Race666/masterclock/README.md

# Mutteruhrsteuerung

Firmware und Schaltungen zum Steuern von sog. Nebenuhren (z.B. Bahnhofsuhren)

Dokumentation und Details auf [albert-hetzles.de](http://albert-hetzles.de/mutteruhr/index.shtml)
