Race666/masterclock/Firmware/atmega168/fuses.png

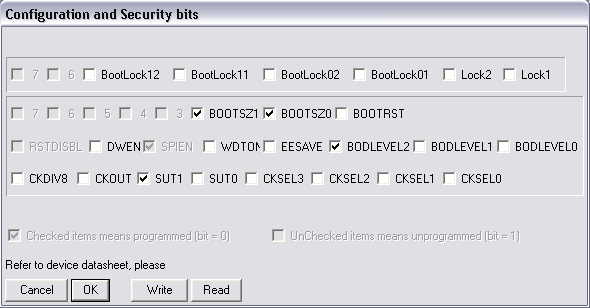
Firmware/atmega168/fuses.png
