Race666/masterclock/Hardware/Mutteruhr V2.0 USB-B - H-Brigde L298 - USB UART LM2576-5/Layout/Bestückung - Mutteruhr-mono-1200dpi.png

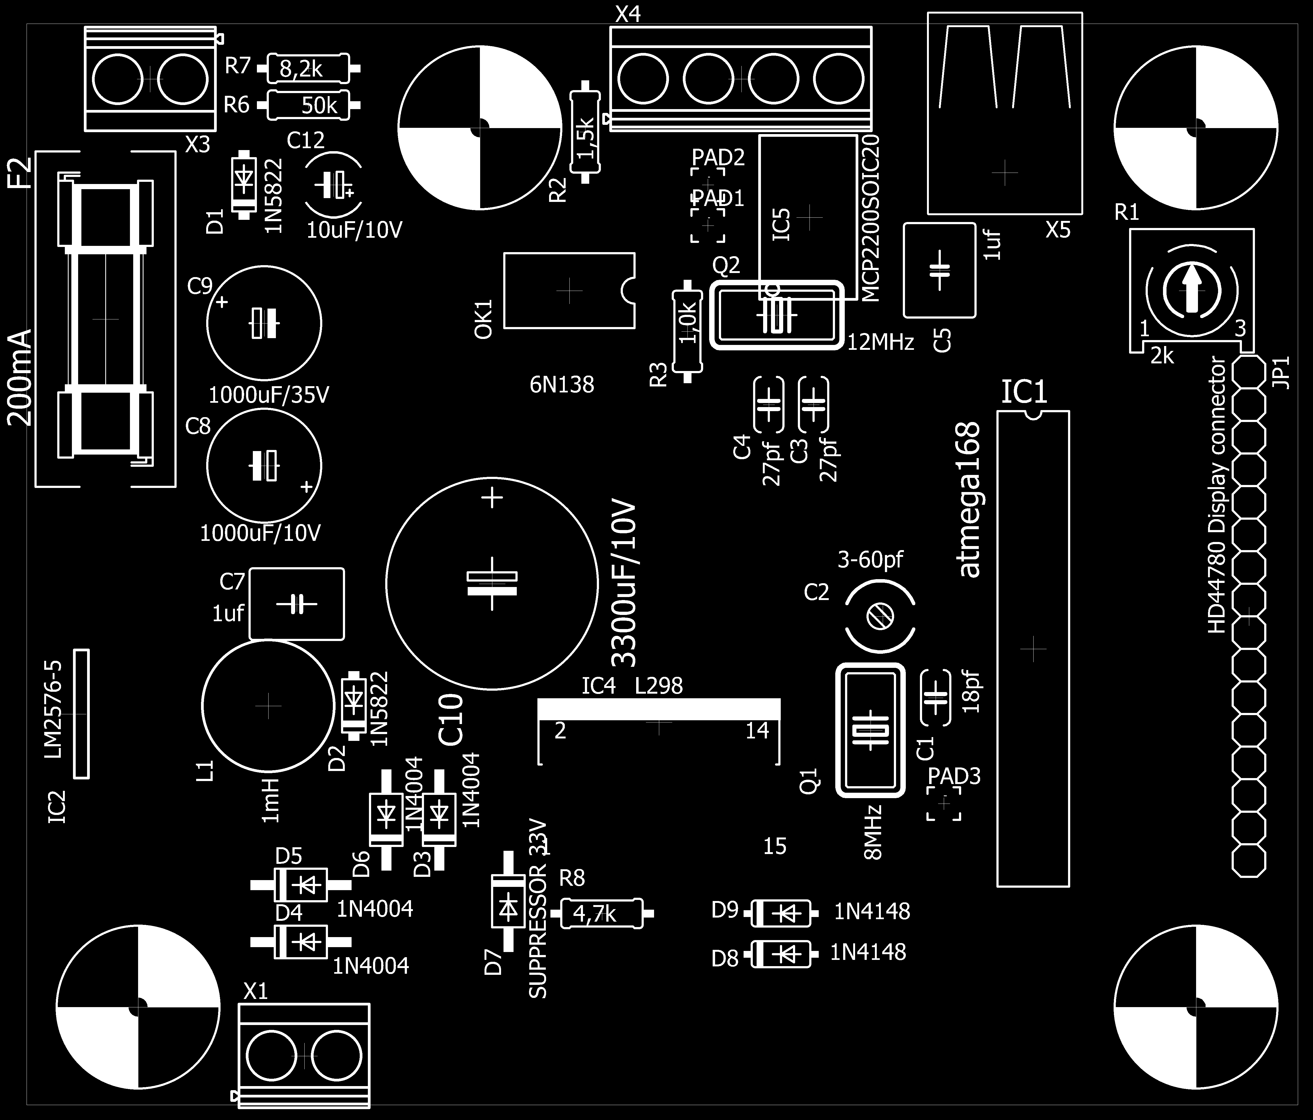
Hardware/Mutteruhr V2.0 USB-B - H-Brigde L298 - USB UART LM2576-5/Layout/Bestückung - Mutteruhr-mono-1200dpi.png
