Race666/masterclock/Hardware/Mutteruhr V2.1 External USB-B - H-Brigde L298 - USB UART LM2576-5/Layout/Bestückung-mutteruhr.png

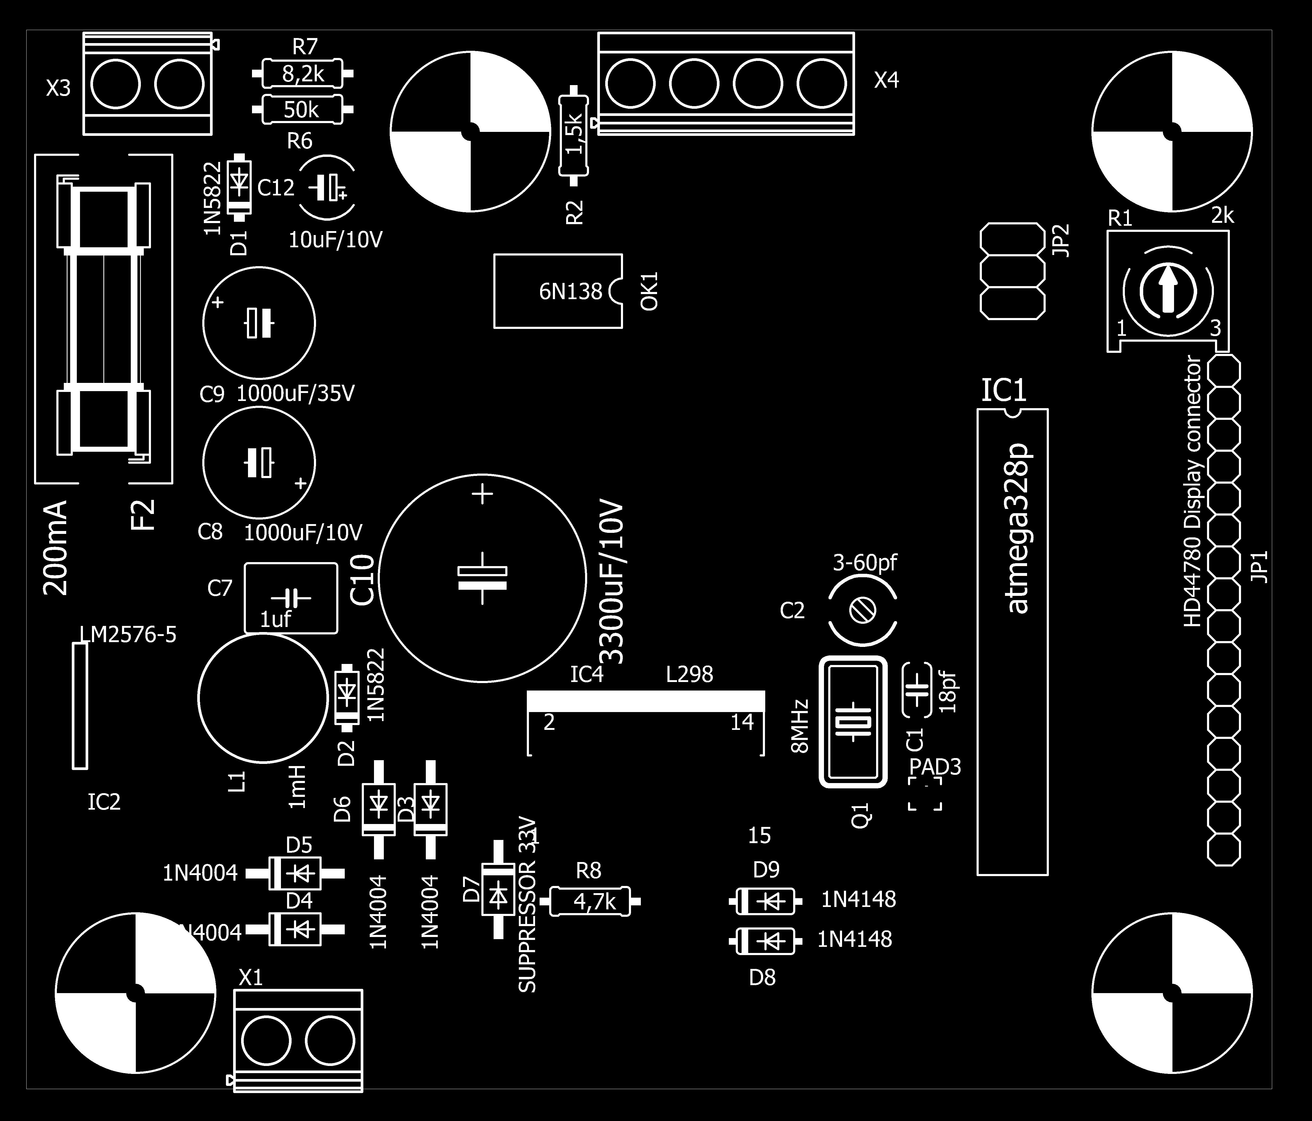
Hardware/Mutteruhr V2.1 External USB-B - H-Brigde L298 - USB UART LM2576-5/Layout/Bestückung-mutteruhr.png
