Race666/masterclock/Hardware/Mutteruhr V3/Mutteruhr/DCF77 Receiver/DCF77 Receiver.kicad_pcb

## KiCad design Hardware/Mutteruhr V3/Mutteruhr/DCF77 Receiver/DCF77 Receiver.kicad_pcb (2023-12-17)

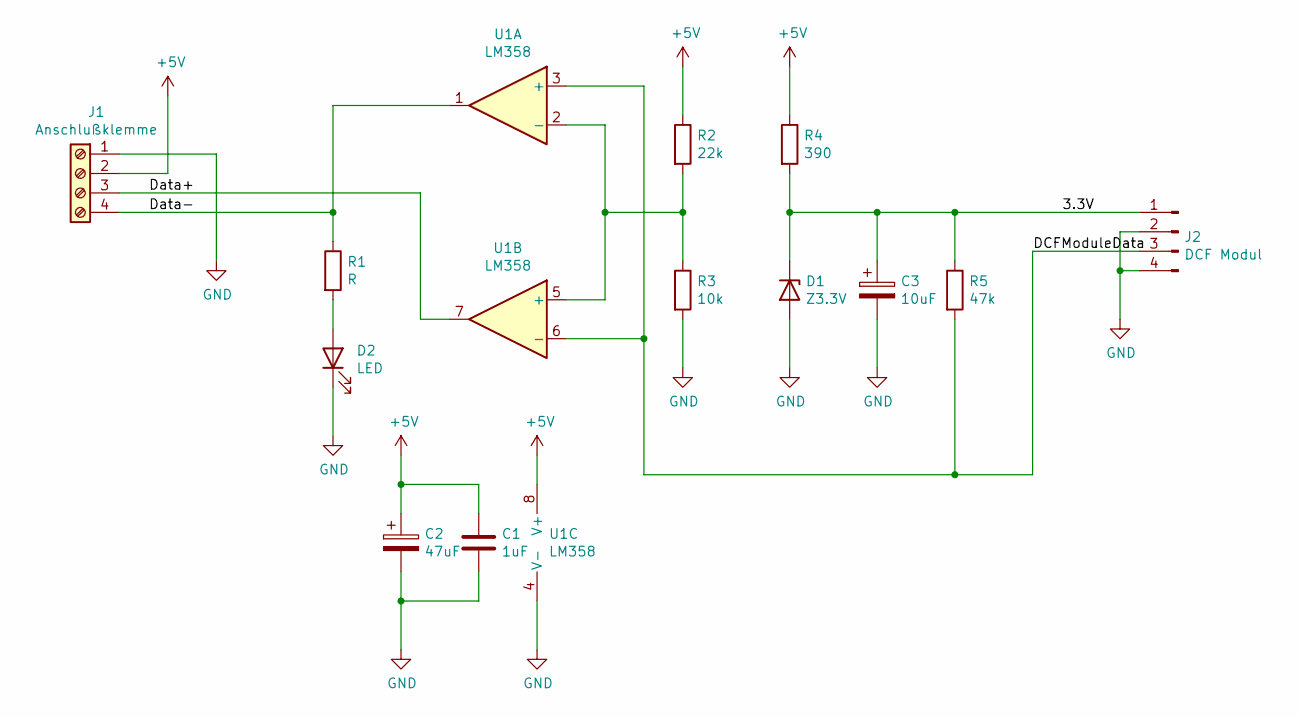
[picture p14: schematic DCF77 Receiver.sch, DCF 77 Empfänger]

Parts:
C1: 1uF; C_Rect_L7.0mm_W3.5mm_P5.00mm
C2: 47uF; CP_Radial_D6.3mm_P2.50mm
C3: 10uF; CP_Radial_D6.3mm_P2.50mm
D1: Z3.3V; D_DO-35_SOD27_P10.16mm_Horizontal
D2: LED; LED_D3.0mm
J1: Anschlußklemme; TerminalBlock_Phoenix_MKDS-3-4-5.08_1x04_P5.08mm_Horizontal
J2: DCF Modul; PinHeader_1x04_P2.54mm_Vertical
R1: R; R_Axial_DIN0207_L6.3mm_D2.5mm_P10.16mm_Horizontal
R2: 22k; R_Axial_DIN0207_L6.3mm_D2.5mm_P10.16mm_Horizontal
R3: 10k; R_Axial_DIN0207_L6.3mm_D2.5mm_P10.16mm_Horizontal
R4: 390; R_Axial_DIN0207_L6.3mm_D2.5mm_P10.16mm_Horizontal
R5: 47k; R_Axial_DIN0207_L6.3mm_D2.5mm_P10.16mm_Horizontal
U1: LM358; DIP-8_W7.62mm_LongPads

Connections:
+5V: C1.1, C2.1, J1.2, R2.1, R4.1, U1.8 (V+)
/3.3V: C3.1, D1.1 (K), J2.1, R4.2, R5.1
/DCFModuleData: J2.3, R5.2, U1.3 (+), U1.6 (-)
/Data+: J1.3, U1.7
/Data-: J1.4, R1.1, U1.1
GND: C1.2, C2.2, C3.2, D1.2 (A), D2.1 (K), J1.1, J2.2, J2.4, R3.2, U1.4 (V-)
unnamed: D2.2 (A), R1.2
unnamed: R2.2, R3.1, U1.2 (-), U1.5 (+)

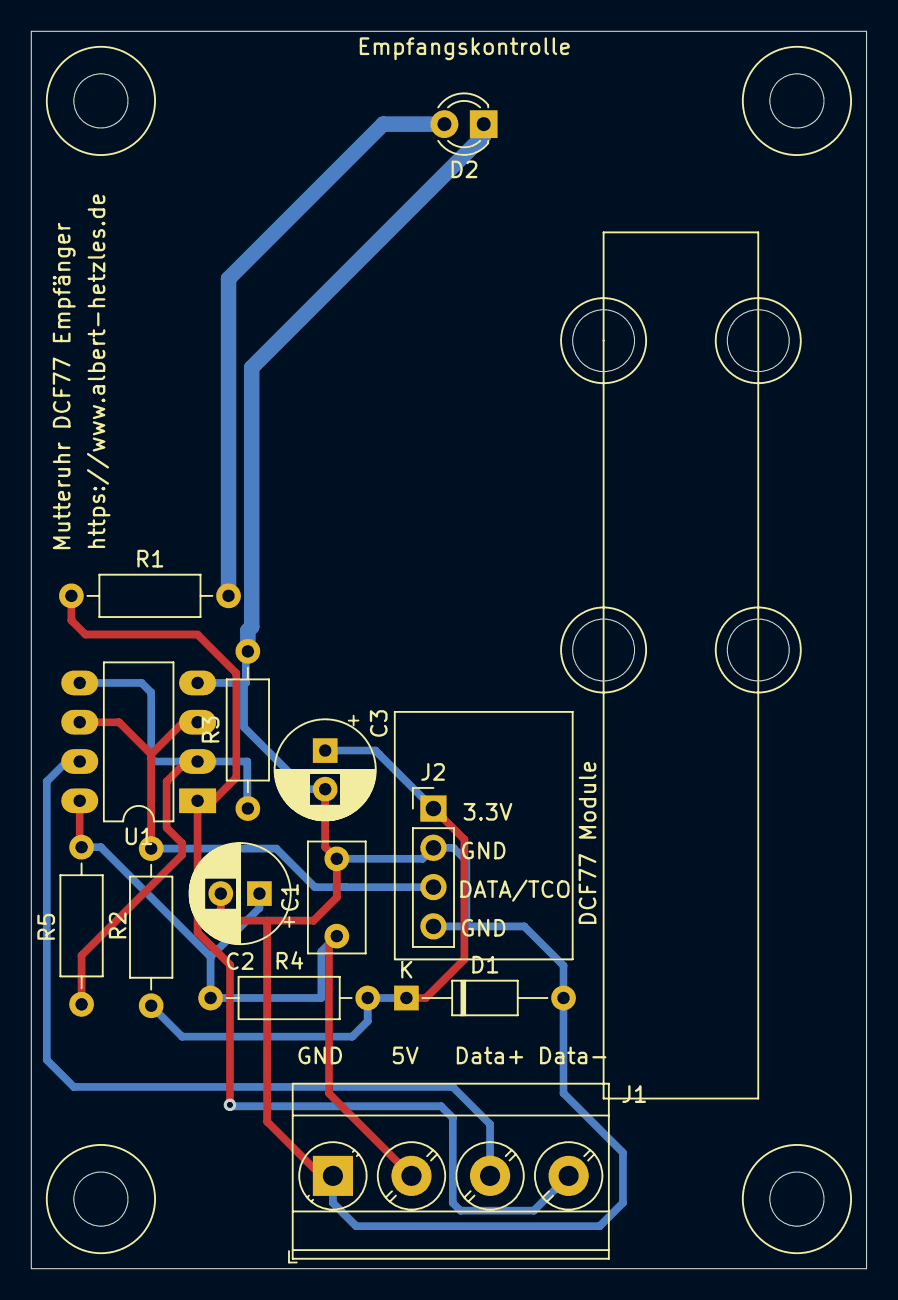
[picture p15: board DCF77 Receiver.kicad_pcb from above]

Board: 2 copper layers, 54.0 x 80.0 mm, 13 parts (0 on the bottom side), 8 nets.
