Race666/masterclock/Hardware/Mutteruhr V3/Mutteruhr/Display/Display Board/Display Board.kicad_pcb

## KiCad design Hardware/Mutteruhr V3/Mutteruhr/Display/Display Board/Display Board.kicad_pcb (2023-12-17)

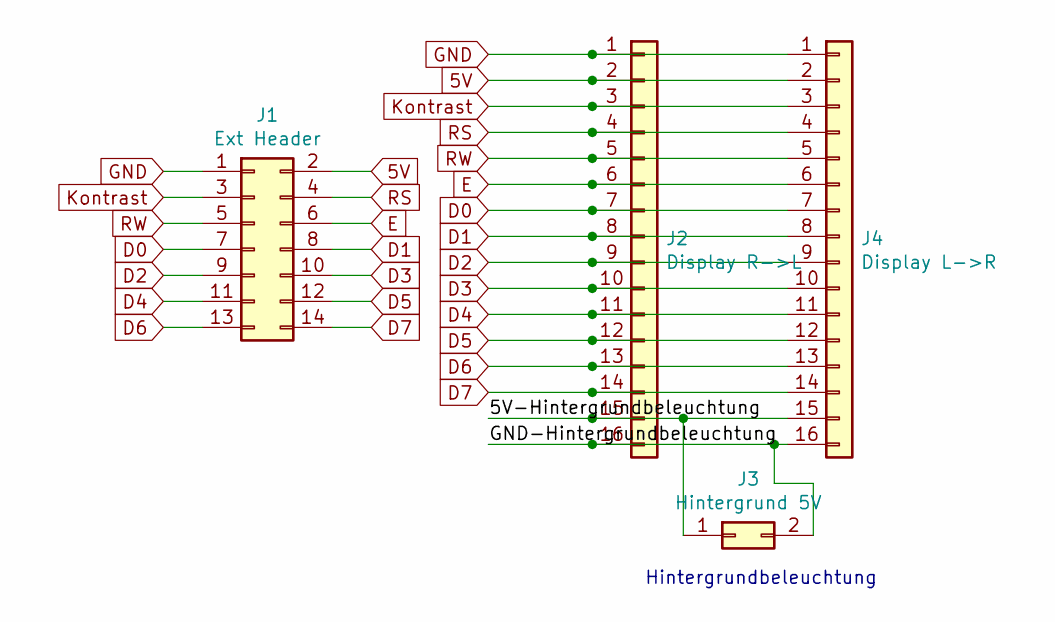
[picture p16: schematic Display Board.sch]

Parts:
J1: Ext Header; PinHeader_2x07_P2.54mm_Vertical
J2: Display R->L; PinHeader_1x16_P2.54mm_Vertical
J3: Hintergrund 5V; PinHeader_1x02_P2.54mm_Vertical
J4: Display L->R; PinHeader_1x16_P2.54mm_Vertical

Connections:
5V: J1.2, J2.2, J4.2
/5V-Hintergrundbeleuchtung: J2.15, J3.1, J4.15
/GND-Hintergrundbeleuchtung: J2.16, J3.2, J4.16
D0: J1.7, J2.7, J4.7
D1: J1.8, J2.8, J4.8
D2: J1.9, J2.9, J4.9
D3: J1.10, J2.10, J4.10
D4: J1.11, J2.11, J4.11
D5: J1.12, J2.12, J4.12
D6: J1.13, J2.13, J4.13
D7: J1.14, J2.14, J4.14
E: J1.6, J2.6, J4.6
GND: J1.1, J2.1, J4.1
Kontrast: J1.3, J2.3, J4.3
RS: J1.4, J2.4, J4.4
RW: J1.5, J2.5, J4.5

Notes on the sheet:
Hintergrundbeleuchtung

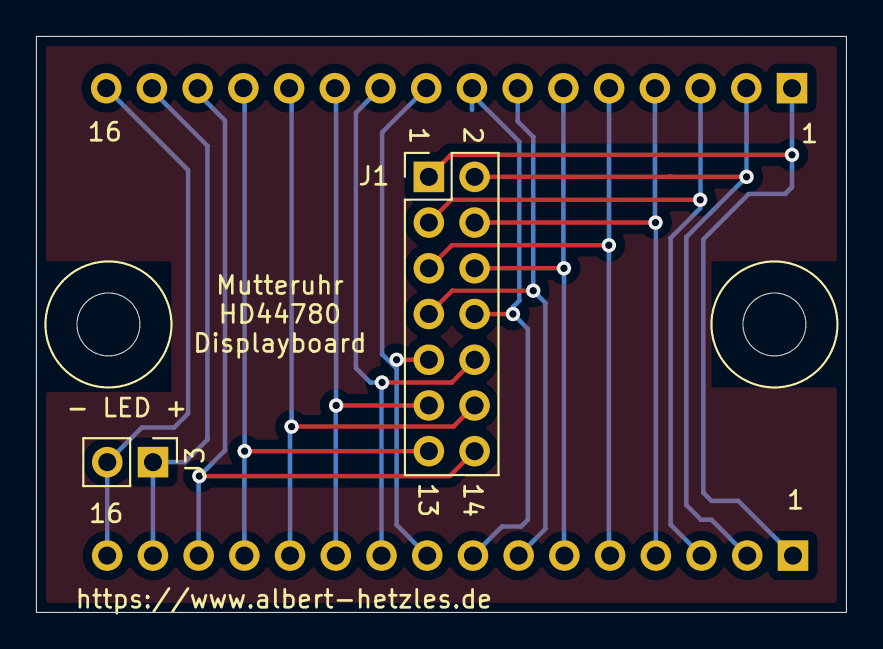
[picture p17: board Display Board.kicad_pcb from above]

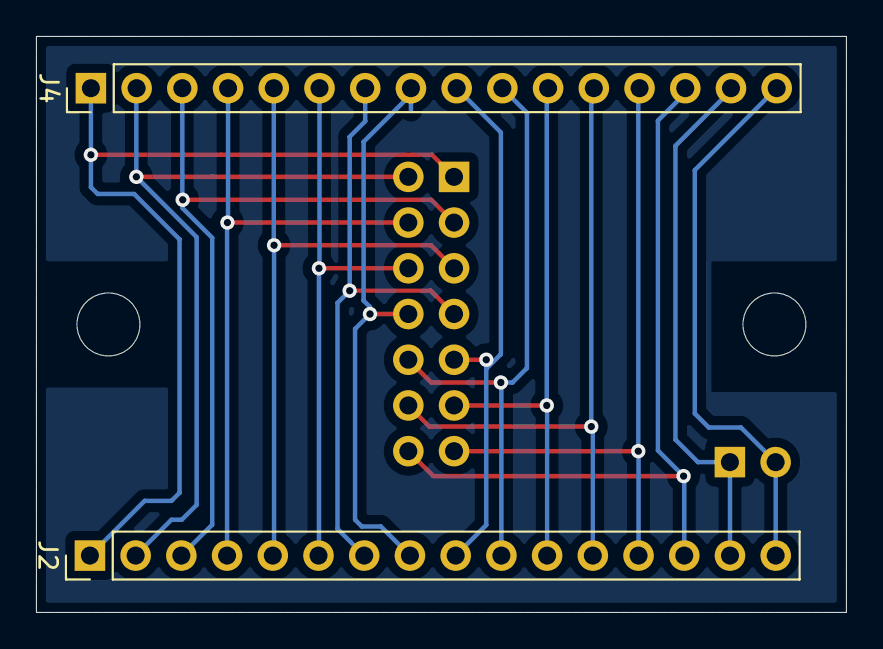
[picture p18: board Display Board.kicad_pcb from below]

Board: 2 copper layers, 45.0 x 32.0 mm, 4 parts (2 on the bottom side), 16 nets.
