Race666/masterclock/Hardware/Mutteruhr V3/Mutteruhr/Mutteruhr/Mutteruhr.kicad_pcb

## KiCad design Hardware/Mutteruhr V3/Mutteruhr/Mutteruhr/Mutteruhr.kicad_pcb (2023-12-17)

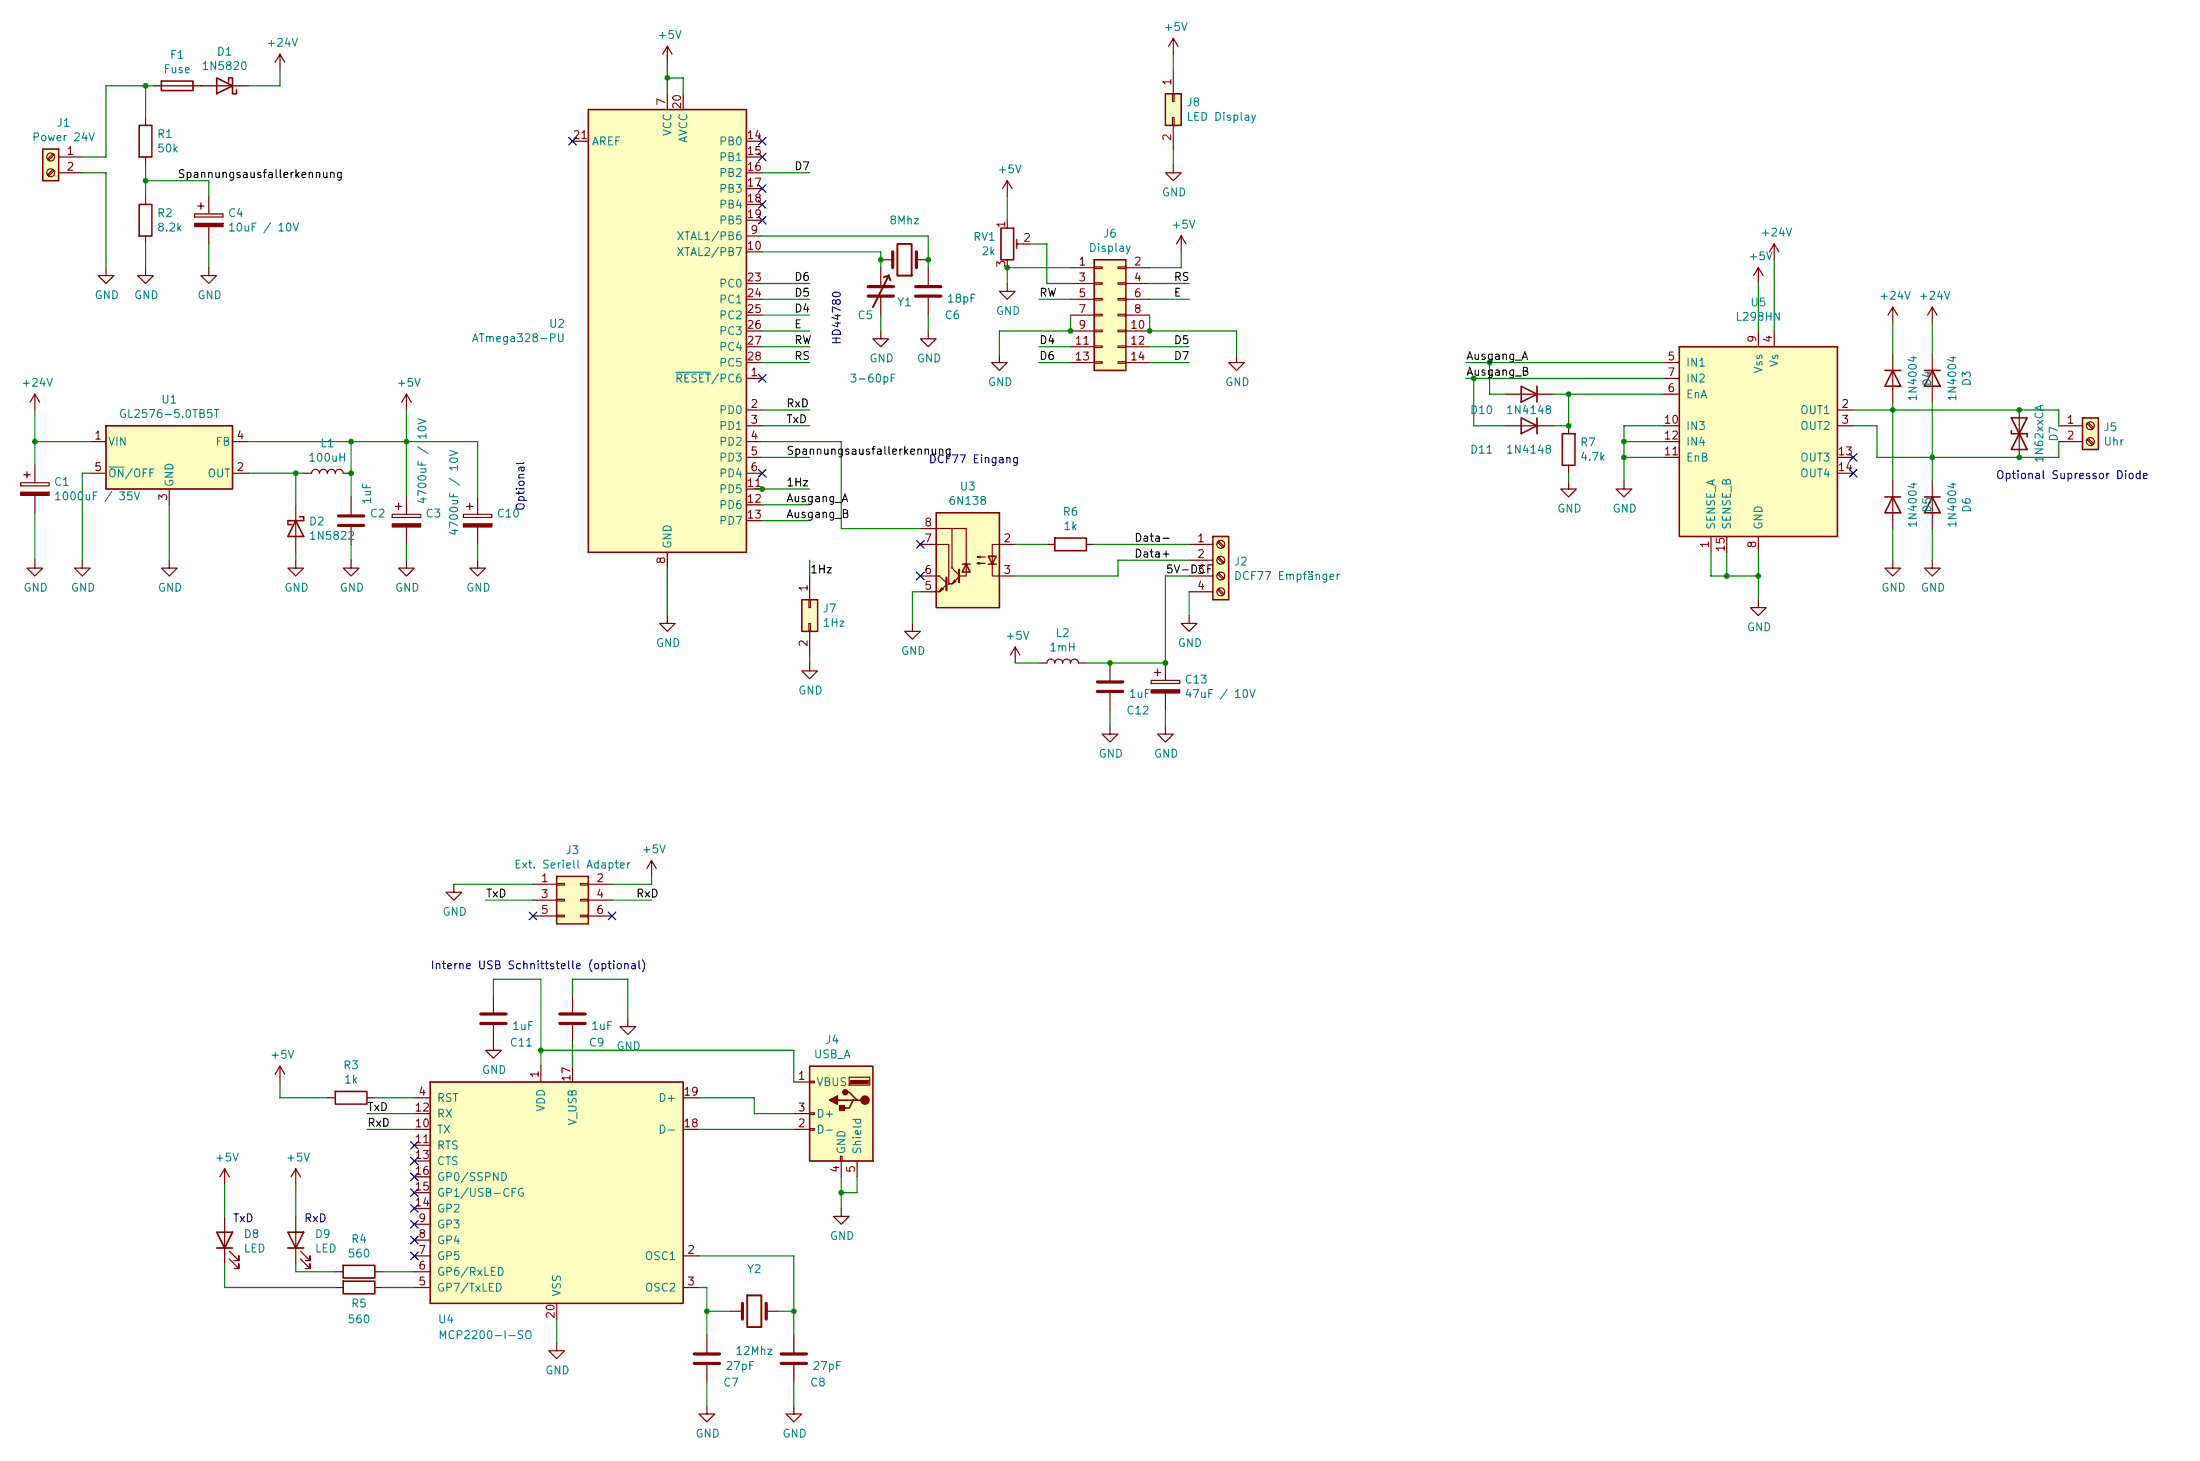
[picture p19: schematic Mutteruhr.kicad_sch, Mutteruhr Mainboard]

Parts:
C1: 1000uF / 35V; CP_Radial_D8.0mm_P5.00mm
C2, C9, C11, C12: 1uF; C_Rect_L7.0mm_W6.0mm_P5.00mm
C3, C10: 4700uF / 10V; CP_Radial_D10.0mm_P7.50mm
C4: 10uF / 10V; CP_Radial_D5.0mm_P2.50mm
C5: 3-60pF; C_Disc_D7.5mm_W5.0mm_P5.00mm
C6: 18pF; C_Disc_D3.0mm_W2.0mm_P2.50mm
C7, C8: 27pF; C_Disc_D3.0mm_W2.0mm_P2.50mm
C13: 47uF / 10V; CP_Radial_Tantal_D4.5mm_P2.50mm
D1: 1N5820; D_DO-41_SOD81_P10.16mm_Horizontal
D2: 1N5822; D_DO-41_SOD81_P10.16mm_Horizontal
D3, D4, D5, D6: 1N4004; D_DO-41_SOD81_P10.16mm_Horizontal
D7: 1N62xxCA; D_DO-41_SOD81_P10.16mm_Horizontal
D8, D9: LED; LED_D3.0mm_FlatTop
D10, D11: 1N4148; D_DO-35_SOD27_P7.62mm_Horizontal
F1: Fuse; Fuse_Bourns_MF-RHT500
J1: Power 24V; TerminalBlock_Phoenix_MKDS-1,5-2-5.08_1x02_P5.08mm_Horizont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
J2: DCF77 Empfänger; TerminalBlock_Phoenix_MKDS-1,5-4-5.08_1x04_P5.08mm_Horizont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
J3: Ext. Seriell Adapter; PinHeader_2x03_P2.54mm_Vertical
J4: USB_A; USB_B_OST_USB-B1HSxx_Horizontal
J5: Uhr; TerminalBlock_Phoenix_MKDS-1,5-2-5.08_1x02_P5.08mm_Horizont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
J6: Display; PinHeader_2x07_P2.54mm_Vertical
J7: 1Hz; PinHeader_1x02_P2.54mm_Vertical
J8: LED Display; PinHeader_1x02_P2.54mm_Vertical
L1: 100uH; L_Radial_D8.7mm_P5.00mm_Fastron_07HCP
L2: 1mH; L_Radial_D8.7mm_P5.00mm_Fastron_07HCP
R1: 50k; R_Axial_DIN0207_L6.3mm_D2.5mm_P10.16mm_Horizontal
R2: 8.2k; R_Axial_DIN0207_L6.3mm_D2.5mm_P10.16mm_Horizontal
R3, R6: 1k; R_Axial_DIN0207_L6.3mm_D2.5mm_P10.16mm_Horizontal
R4, R5: 560; R_Axial_DIN0204_L3.6mm_D1.6mm_P2.54mm_Vertical
R7: 4.7k; R_Axial_DIN0207_L6.3mm_D2.5mm_P10.16mm_Horizontal
RV1: 2k; Potentiometer_ACP_CA6-H2,5_Horizontal
U1: GL2576-5.0TB5T; TO-220-5_Vertical
U2: ATmega328-PU; DIP-28_W7.62mm
U3: 6N138; DIP-8_W7.62mm_LongPads
U4: MCP2200-I-SO; SOIC-20W_7.5x12.8mm_P1.27mm
U5: L298HN; TO-220-15_P2.54x2.54mm_StaggerOdd_Lead4.58mm_Vertical
Y1: 8Mhz; Crystal_HC49-U_Vertical
Y2: 12Mhz; Crystal_HC49-U_Vertical

Connections:
+5V: C2.1, C3.1, C10.1, D8.2 (A), D9.2 (A), J3.2, J6.2, J8.1, L1.2, L2.1, R3.2, RV1.1, U1.4 (FB), U2.7 (VCC), U2.20 (AVCC), U5.9 (Vss)
+24V: C1.1, D1.1 (K), D3.1 (K), D4.1 (K), U1.1 (VIN), U5.4 (Vs)
/1Hz: J7.1, U2.11 (PD5)
/5V-DCF: C12.1, C13.1, J2.3, L2.2
/Ausgang_A: D10.2 (A), U2.12 (PD6), U5.5 (IN1)
/Ausgang_B: D11.2 (A), U2.13 (PD7), U5.7 (IN2)
/D4: J6.11, U2.25 (PC2)
/D5: J6.12, U2.24 (PC1)
/D6: J6.13, U2.23 (PC0)
/D7: J6.14, U2.16 (PB2)
/Data+: J2.2, U3.3 (C2)
/Data-: J2.1, R6.1
/E: J6.6, U2.26 (PC3)
/RS: J6.4, U2.28 (PC5)
/RW: J6.5, U2.27 (PC4)
/RxD: J3.4, U2.2 (PD0), U4.10 (TX)
/Spannungsausfallerkennung: C4.1, R1.2, R2.1, U2.5 (PD3)
/TxD: J3.3, U2.3 (PD1), U4.12 (RX)
GND: C1.2, C2.2, C3.2, C4.2, C5.2, C6.2, C7.2, C8.2, C9.1, C10.2, C11.2, C12.2, C13.2, D2.2 (A), D5.2 (A), D6.2 (A), J1.2, J2.4, J3.1, J4.4 (GND), J4.5 (Shield), J6.1, J6.7, J6.8, J6.9, J6.10, J7.2, J8.2, R2.2, R7.1, RV1.3, U1.3 (GND), U1.5 (~ON/OFF), U2.8 (GND), U2.22 (GND), U3.5 (GND), U4.20 (VSS), U5.1 (SENSE_A), U5.8 (GND), U5.10 (IN3), U5.11 (EnB), U5.12 (IN4), U5.15 (SENSE_B)
unnamed: C5.1, U2.10 (XTAL2/PB7), Y1.2
unnamed: C6.1, U2.9 (XTAL1/PB6), Y1.1
unnamed: C7.1, U4.3 (OSC2), Y2.1
unnamed: C8.1, U4.2 (OSC1), Y2.2
unnamed: C9.2, U4.17 (V_USB)
unnamed: C11.1, J4.1 (VBUS), U4.1 (VDD)
unnamed: D1.2 (A), F1.1
unnamed: D2.1 (K), L1.1, U1.2 (OUT)
unnamed: D3.2 (A), D6.1 (K), D7.2 (A2), J5.2, U5.3 (OUT2)
unnamed: D4.2 (A), D5.1 (K), D7.1 (A1), J5.1, U5.2 (OUT1)
unnamed: D8.1 (K), R5.2
unnamed: D9.1 (K), R4.2
unnamed: D10.1 (K), D11.1 (K), R7.2, U5.6 (EnA)
unnamed: F1.2, J1.1, R1.1
unnamed: J4.2 (D-), U4.18 (D-)
unnamed: J4.3 (D+), U4.19 (D+)
unnamed: J6.3, RV1.2
unnamed: R3.1, U4.4 (RST)
unnamed: R4.1, U4.6 (GP6/RxLED)
unnamed: R5.1, U4.5 (GP7/TxLED)
unnamed: R6.2, U3.2 (C1)
unnamed: U2.4 (PD2), U3.8 (VCC)

Notes on the sheet:
RxD
Optional
Optional Supressor Diode
Interne USB Schnittstelle (optional)
HD44780
TxD
DCF77 Eingang

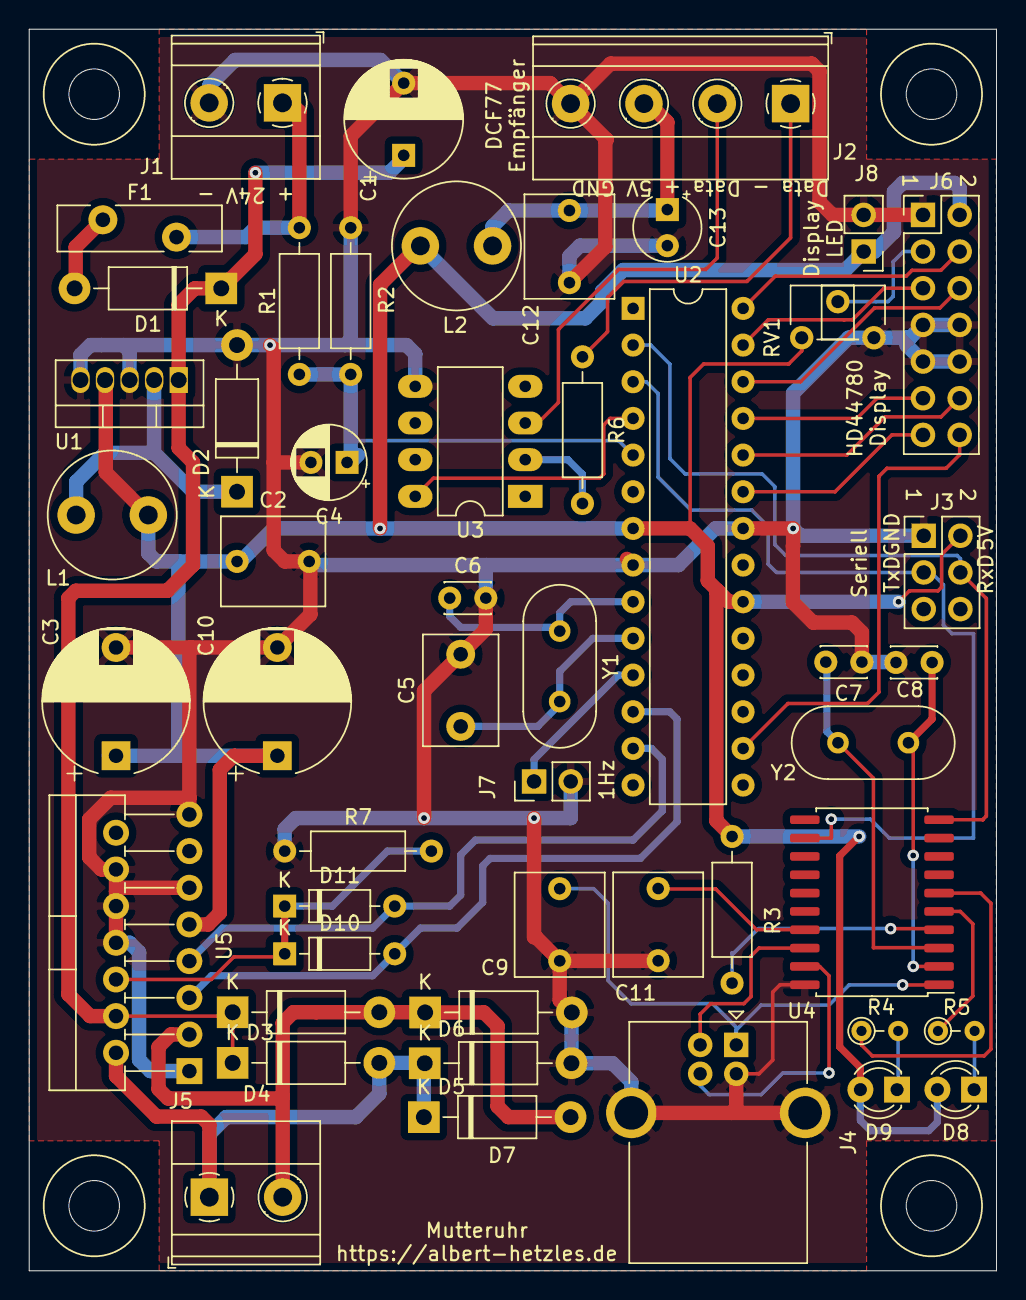
[picture p20: board Mutteruhr.kicad_pcb from above]

Board: 2 copper layers, 67.0 x 86.0 mm, 50 parts (0 on the bottom side), 41 nets.
