Race666/masterclock/Hardware/Mutteruhr V2.1 External USB-B - H-Brigde L298 - USB UART LM2576-5/USB-Board.brd

## EAGLE design Hardware/Mutteruhr V2.1 External USB-B - H-Brigde L298 - USB UART LM2576-5/USB-Board.brd (2020-07-01)

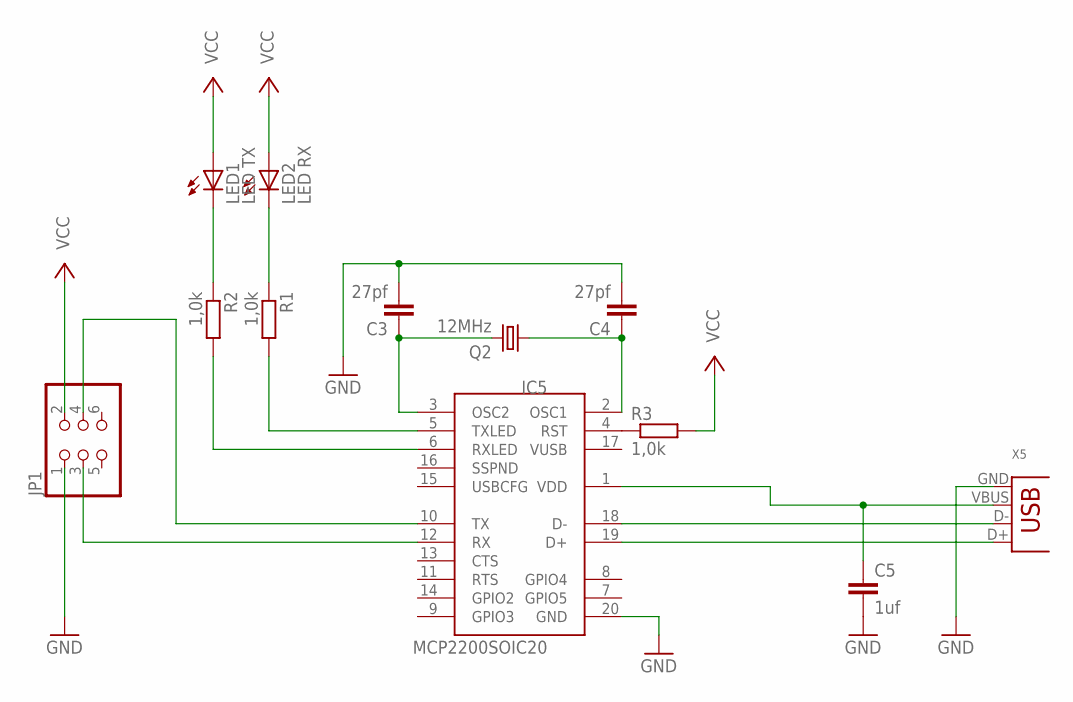
[picture p21: schematic USB-Board.sch]

Parts:
C3, C4: 27pf; C050-024X044
C5: 1uf; C5B5.5
IC5: MCP2200SOIC20; SOIC20
JP1: PINHD-2X3; 2X03
LED1: LED TX; LED3MM
LED2: LED RX; LED3MM
Q2: 12MHz; HC18U-V
R1, R2, R3: 1,0k; 0207/10
X5: USB-B-H

Connections:
GND: C3.2, C4.2, C5.2, IC5.20 (GND), JP1.1, X5.GND
unnamed: LED1.K (C), R2.1
unnamed: LED2.K (C), R1.1
unnamed: IC5.18 (D-), X5.D-
unnamed: IC5.19 (D+), X5.D+
unnamed: IC5.10 (TX), JP1.4
unnamed: IC5.12 (RX), JP1.3
unnamed: IC5.4 (RST), R3.1
unnamed: C3.1, IC5.3 (OSC2), Q2.2
unnamed: C4.1, IC5.2 (OSC1), Q2.1
unnamed: IC5.6 (RXLED), R2.2
unnamed: IC5.5 (TXLED), R1.2
unnamed: C5.1, IC5.1 (VDD), X5.VBUS
VCC: JP1.2, LED1.A, LED2.A, R3.2

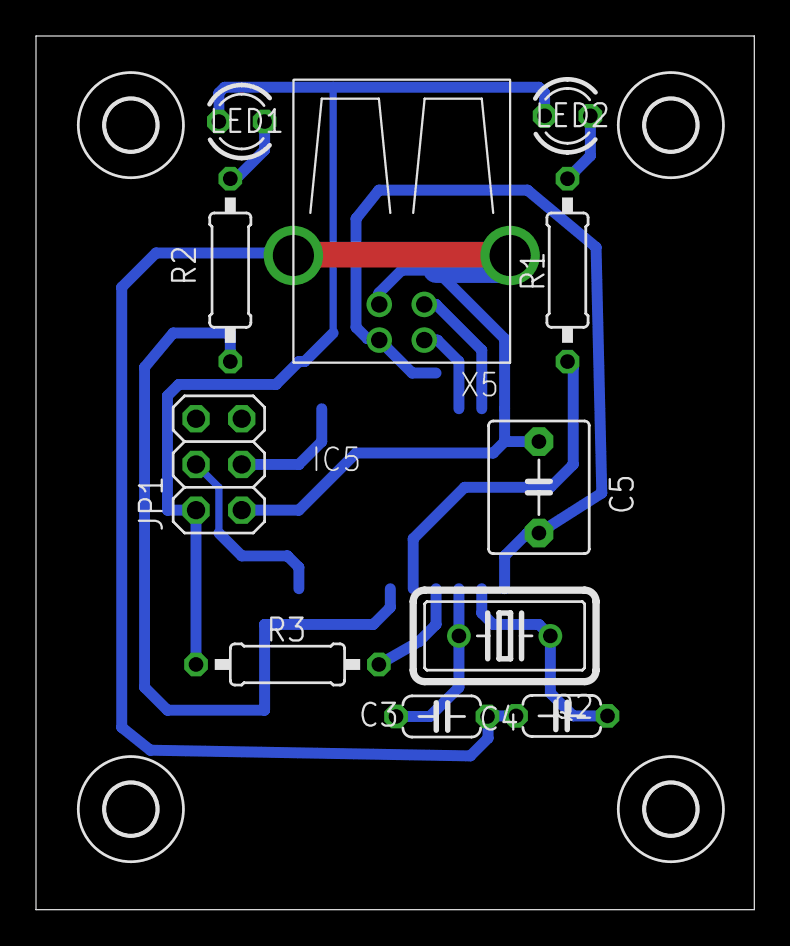
[picture p22: board USB-Board.brd from above]

Board: 2 copper layers, 39.9 x 48.5 mm, 16 parts (1 on the bottom side), 14 nets.

Other parts of the board:
U$1, U$2, U$3, U$4: 2,8
