Race666/masterclock/Hardware/Mutteruhr V2.0 USB-B - H-Brigde L298 - USB UART LM2576-5/mutteruhr-Haus.brd

## EAGLE design Hardware/Mutteruhr V2.0 USB-B - H-Brigde L298 - USB UART LM2576-5/mutteruhr-Haus.brd (2020-07-01)

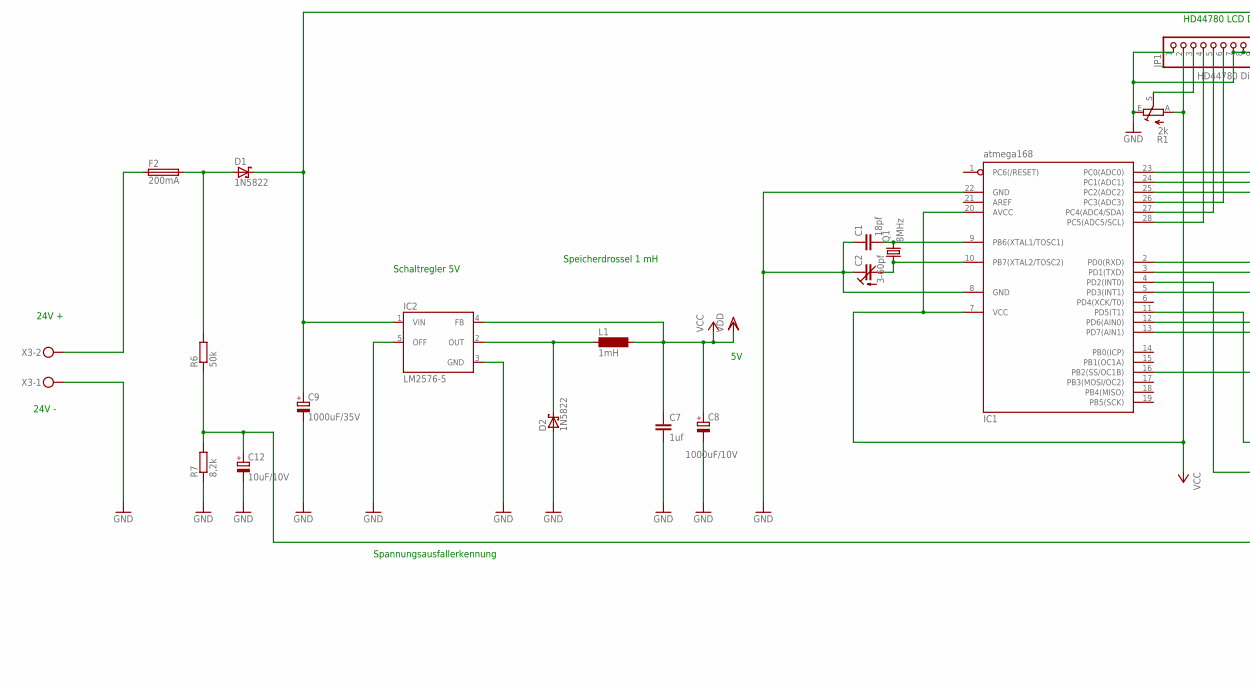
[picture p23: schematic mutteruhr-Haus.sch, part in row 1, column 1]

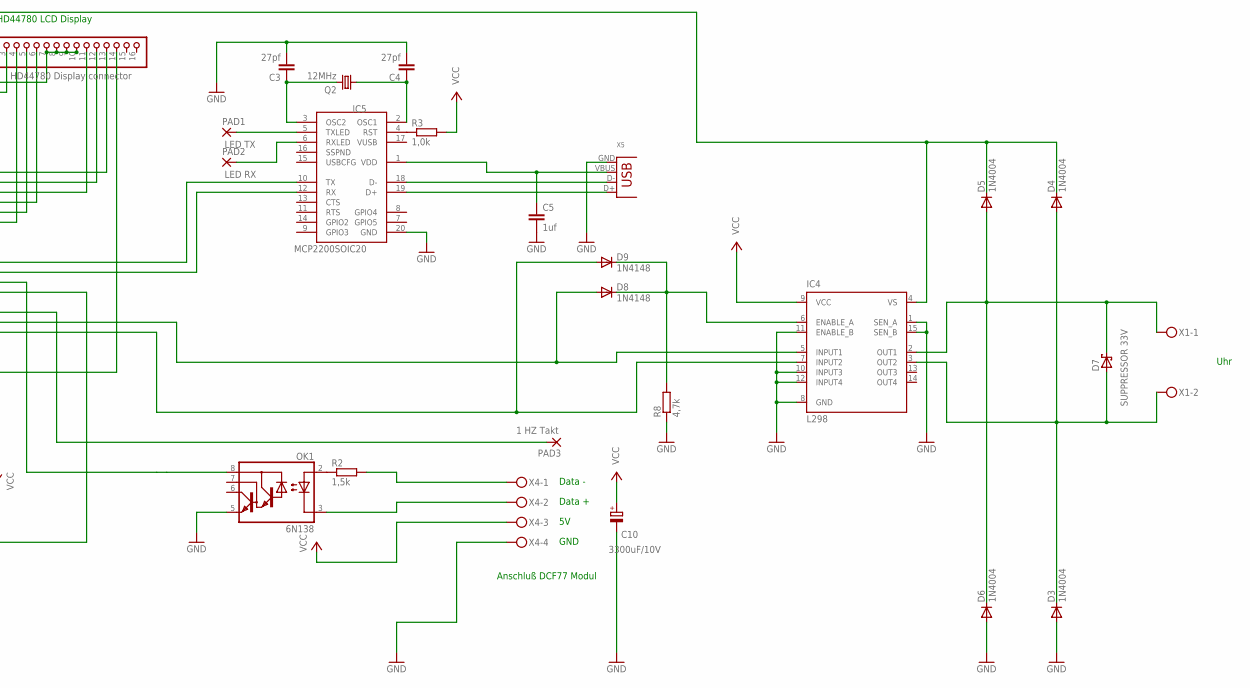
[picture p24: schematic mutteruhr-Haus.sch, part in row 1, column 2]

Parts:
C1: 18pf; C050-024X044
C2: 3-60pf; CTRIM3050.505
C3, C4: 27pf; C050-024X044
C5, C7: 1uf; C5B5.5
C8: 1000uF/10V; E5-8,5
C9: 1000uF/35V; E5-8,5
C10: 3300uF/10V; E7,5-16
C12: 10uF/10V; E5-5
D1, D2: 1N5822; DO41-7.6
D3, D4, D5, D6: 1N4004; DO41-10
D7: SUPPRESSOR 33V; DO41-10
D8, D9: 1N4148; DO35-7
F2: 200mA; SH25
IC1: atmega168; DIL28-3
IC2: LM2576-5; TO220-5
IC4: L298; MULTIWATT-15
IC5: MCP2200SOIC20; SOIC20
JP1: HD44780 Display connector; 1X16
L1: 1mH; BS11
OK1: 6N138; DIL08
PAD1: LED TX; 2,54/0,8
PAD2: LED RX; 2,54/0,8
PAD3: 1 HZ Takt; 2,54/0,8
Q1: 8MHz; HC18U-V
Q2: 12MHz; HC18U-V
R1: 2k; RS3
R2: 1,5k; 0207/10
R3: 1,0k; 0207/10
R6: 50k; 0207/10
R7: 8,2k; 0207/10
R8: 4,7k; 0207/10
X1, X3: MKDSN1,5/2-5,08
X4: MKDSN1,5/4-5,08
X5: USB-B-H

Connections:
GND: C1.1, C2.1 (E), C3.2, C4.2, C5.2, C7.2, C8.-, C9.-, C10.-, C12.-, D2.A, D3.A, D6.A, IC1.8 (GND), IC1.22 (GND), IC2.3 (GND), IC2.5 (OFF), IC4.1 (SEN_A), IC4.8 (GND), IC4.10 (INPUT3), IC4.11 (ENABLE_B), IC4.12 (INPUT4), IC4.15 (SEN_B), IC5.20 (GND), JP1.1, JP1.7, JP1.8, JP1.9, JP1.10, OK1.5 (GND), R1.E, R7.1, R8.1, X3.1, X4.4, X5.GND
unnamed: IC1.4 (PD2(INT0)), OK1.8 (VCC)
unnamed: C1.2, IC1.9 (PB6(XTAL1/TOSC1)), Q1.2
unnamed: C2.2 (A), IC1.10 (PB7(XTAL2/TOSC2)), Q1.1
unnamed: IC1.23 (PC0(ADC0)), JP1.13
unnamed: IC1.24 (PC1(ADC1)), JP1.12
unnamed: IC1.25 (PC2(ADC2)), JP1.11
unnamed: IC1.26 (PC3(ADC3)), JP1.6
unnamed: IC1.27 (PC4(ADC4/SDA)), JP1.5
unnamed: IC1.28 (PC5(ADC5/SCL)), JP1.4
unnamed: IC1.16 (PB2(SS/OC1B)), JP1.14
unnamed: IC5.18 (D-), X5.D-
unnamed: JP1.3, R1.S
unnamed: IC5.19 (D+), X5.D+
unnamed: IC1.2 (PD0(RXD)), IC5.10 (TX)
unnamed: IC1.3 (PD1(TXD)), IC5.12 (RX)
unnamed: IC5.4 (RST), R3.1
unnamed: C3.1, IC5.3 (OSC2), Q2.2
unnamed: C4.1, IC5.2 (OSC1), Q2.1
unnamed: IC5.6 (RXLED), PAD2.1
unnamed: IC5.5 (TXLED), PAD1.1
unnamed: D9.A, IC1.13 (PD7(AIN1)), IC4.7 (INPUT2)
unnamed: OK1.2 (A), R2.1
unnamed: C5.1, IC5.1 (VDD), X5.VBUS
unnamed: IC1.11 (PD5(T1)), PAD3.1
unnamed: D1.A, F2.2, R6.2
unnamed: OK1.3 (C), X4.2
unnamed: C9.+, D1.C, D4.C, D5.C, IC2.1 (VIN), IC4.4 (VS)
unnamed: F2.1, X3.2
unnamed: R2.2, X4.1
unnamed: C12.+, IC1.5 (PD3(INT1)), R6.1, R7.2
unnamed: D2.C, IC2.2 (OUT), L1.1
unnamed: D8.C, D9.C, IC4.6 (ENABLE_A), R8.2
unnamed: D3.C, D4.A, D7.A, IC4.3 (OUT2), X1.2
unnamed: D8.A, IC1.12 (PD6(AIN0)), IC4.5 (INPUT1)
unnamed: D5.A, D6.C, D7.C, IC4.2 (OUT1), X1.1
VCC: C7.1, C8.+, C10.+, IC1.7 (VCC), IC1.20 (AVCC), IC2.4 (FB), IC4.9 (VCC), JP1.2, L1.2, R1.A, R3.2, X4.3

Notes on the sheet:
Speicherdrossel 1 mH
Schaltregler 5V
HD44780 LCD Display
24V +
24V -
Anschluß DCF77 Modul
GND
Data +
Data -
Uhr
Spannungsausfallerkennung

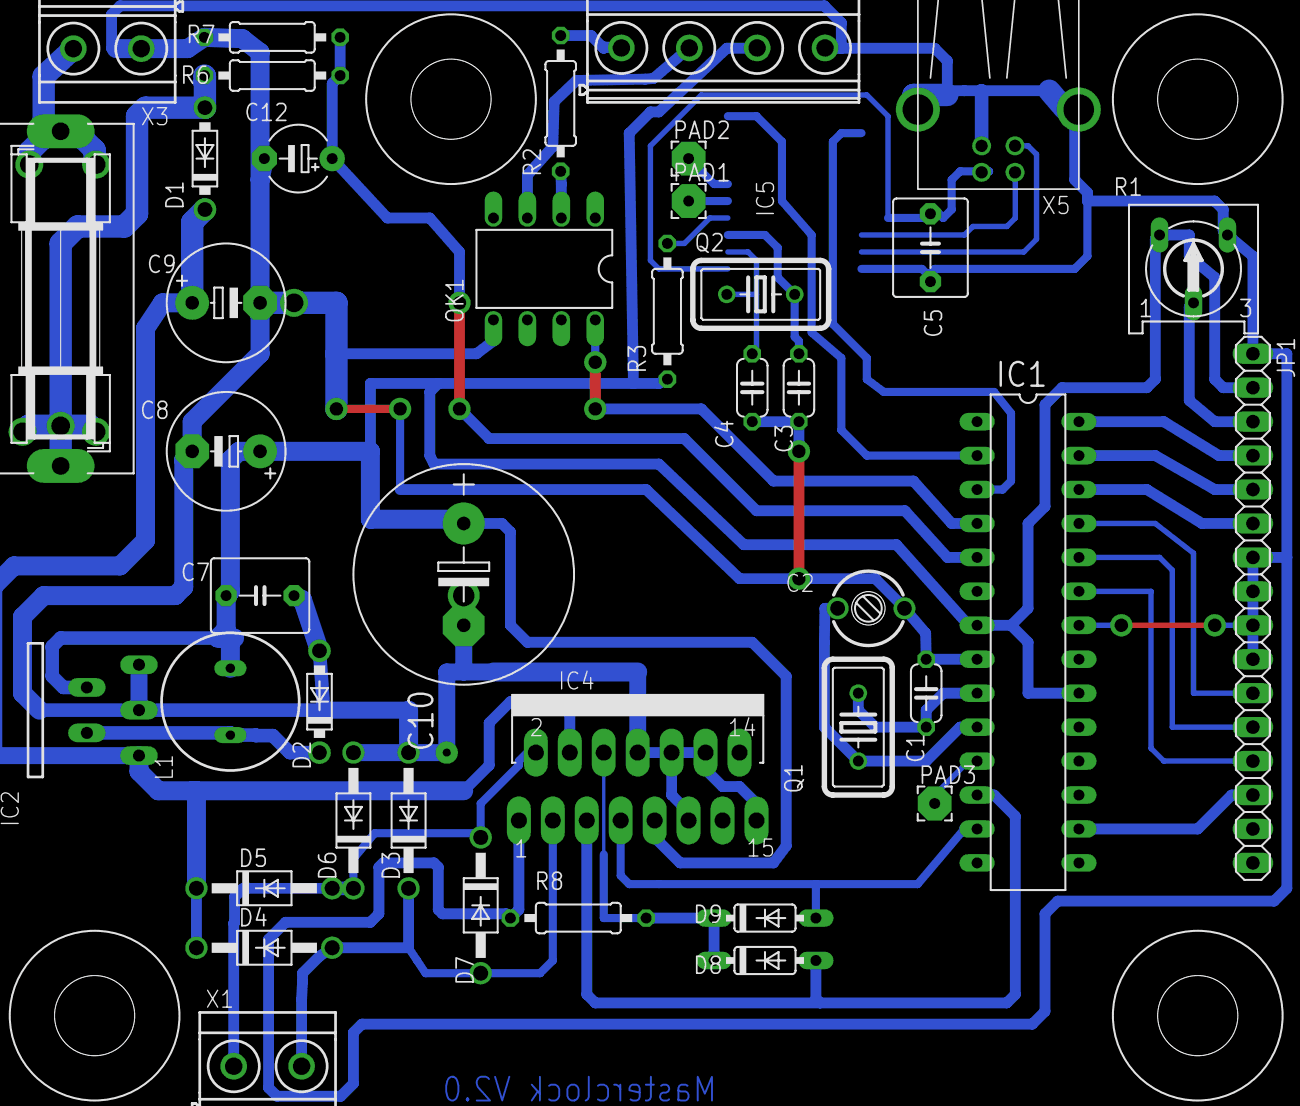
[picture p25: board Hardware/Mutteruhr V2.0 USB-B - H-Brigde L298 - USB UART LM2576-5/mut… from above]

Board: 2 copper layers, 46 parts (1 on the bottom side), 37 nets.

Other parts of the board:
U$1, U$2, U$3, U$4: DRIL-6
