Race666/masterclock/Hardware/Mutteruhr V1.0/dcf77kompZDiff.brd

## EAGLE design Hardware/Mutteruhr V1.0/dcf77kompZDiff.brd (2016-11-09, an earlier design)

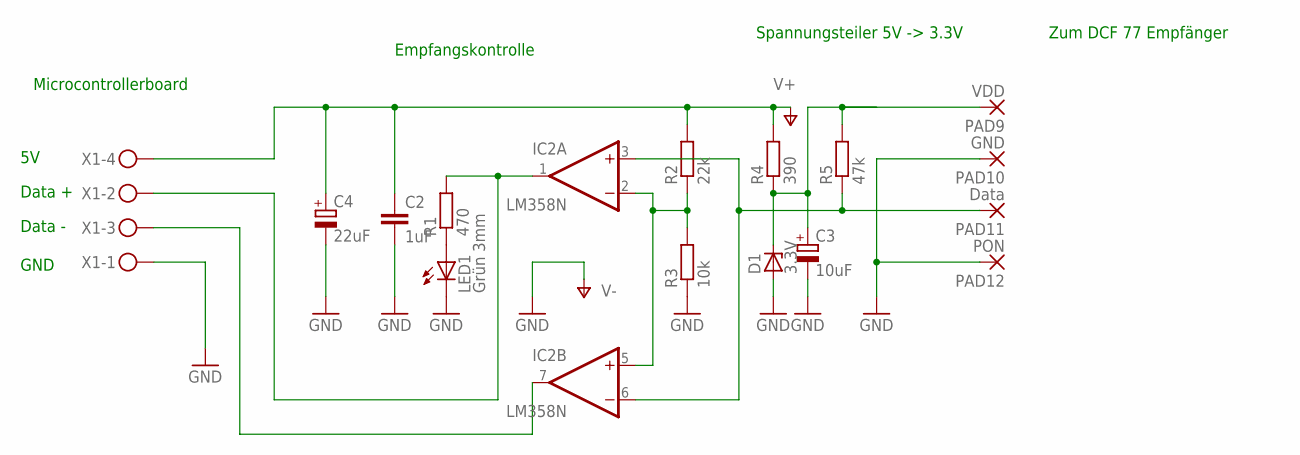
[picture p26: schematic dcf77kompZDiff.sch]

Parts:
C2: 1uF; C050-050X075
C3: 10uF; E2,5-5
C4: 22uF; E5-10,5
D1: 3.3V; DO34Z7
IC2: LM358N; DIL08
LED1: Grün 3mm; LED5MM
PAD9: VDD; 1,6/0,9
PAD10: GND; 1,6/0,9
PAD11: Data; 1,6/0,9
PAD12: PON; 1,6/0,9
R1: 470; 0207/10
R2: 22k; 0207/10
R3: 10k; 0207/10
R4: 390; 0207/10
R5: 47k; 0207/10
X1: MKDSN1,5/4-5,08

Connections:
GND: C2.2, C3.-, C4.-, D1.A, IC2.4 (V-), LED1.K (C), PAD10.1, PAD12.1, R3.1, X1.1
unnamed: C3.+, D1.C, PAD9.1, R4.1, R5.2
unnamed: LED1.A, R1.1
unnamed: IC2.1 (OUT), R1.2, X1.2
unnamed: IC2.7 (OUT), X1.3
unnamed: IC2.2 (-IN), IC2.5 (+IN), R2.1, R3.2
unnamed: IC2.3 (+IN), IC2.6 (-IN), PAD11.1, R5.1
V+: C2.1, C4.+, IC2.8 (V+), R2.2, R4.2, X1.4

Notes on the sheet:
Zum DCF 77 Empfänger
Microcontrollerboard
Empfangskontrolle
Spannungsteiler 5V -> 3.3V
Data +
Data -
GND

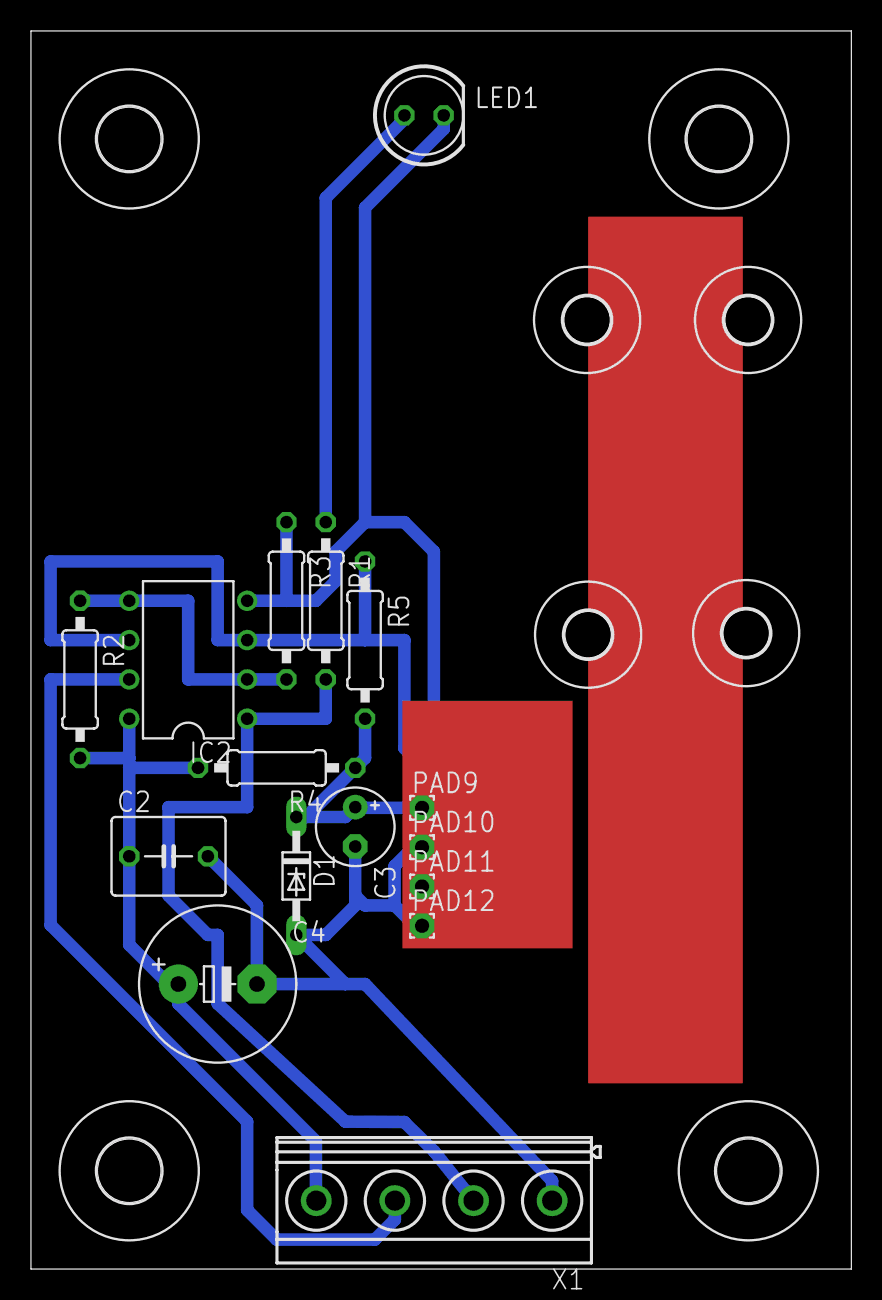
[picture p27: board dcf77kompZDiff.brd from above]

Board: 2 copper layers, 53.0 x 80.0 mm, 24 parts (0 on the bottom side), 8 nets.

Other parts of the board:
U$1, U$2, U$3, U$4: 4,1
U$5, U$6, U$7, U$8: 3,0
