Race666/masterclock/Hardware/Mutteruhr V1.0/mutteruhr-Haus.brd

## EAGLE design Hardware/Mutteruhr V1.0/mutteruhr-Haus.brd (2016-11-09, an earlier design)

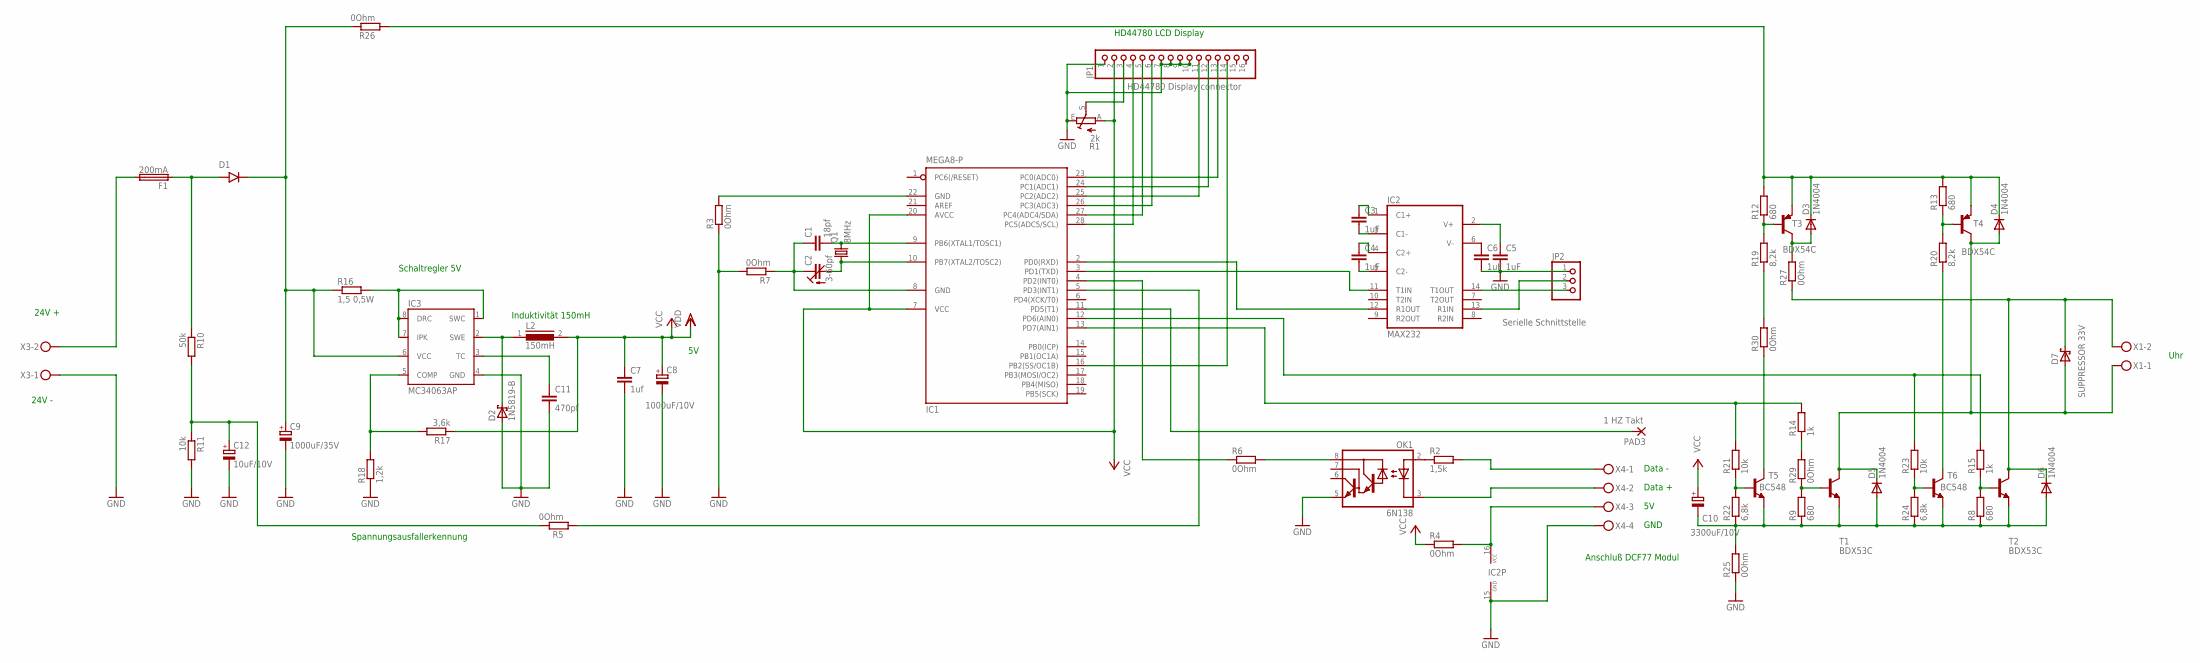
[picture p28: schematic mutteruhr-Haus.sch]

Parts:
C1: 18pf; C050-024X044
C2: 3-60pf; CTRIM3050.505
C3, C4, C5, C6: 1uF; C5B5.5
C7: 1uf; C5B5.5
C8: 1000uF/10V; E5-8,5
C9: 1000uF/35V; E5-8,5
C10: 3300uF/10V; E7,5-16
C11: 470pf; C5B5.5
C12: 10uF/10V; E5-5
D1: 1N4001; DO41-10
D2: 1N5819-B; DO41-7.6
D3, D4, D5, D6: 1N4004; DO41-10
D7: SUPPRESSOR 33V; DO41-10
F1: 200mA; GSH15
IC1: MEGA8-P; DIL28-3
IC2: MAX232; DIL16
IC3: MC34063AP; DIL-08
JP1: HD44780 Display connector; 1X16
JP2: Serielle Schnittstelle; 1X03
L2: 150mH; 82114R
OK1: 6N138; DIL08
PAD3: 1 HZ Takt; 2,54/0,8
Q1: 8MHz; HC18U-V
R1: 2k; RS3
R2: 1,5k; 0204/7
R3, R4, R5, R6, R7, R25, R26: 0Ohm; 0204/7
R8, R9, R12, R13: 680; 0207/10
R10: 50k; 0204/7
R11: 10k; 0204/7
R14, R15: 1k; 0207/10
R16: 1,5 0,5W; 0204/7
R17: 3,6k; 0204/7
R18: 1,2k; 0204/7
R19, R20: 8,2k; 0207/10
R21, R23: 10k; 0207/10
R22, R24: 6,8k; 0204V
R27, R29, R30: 0Ohm; 0207/10
T1, T2: BDX53C; TO220V
T3, T4: BDX54C; TO220V
T5, T6: BC548; TO92-EBC
X1, X3: MKDSN1,5/2-5,08
X4: MKDSN1,5/4-5,08

Connections:
GND: C5.2, C6.2, C7.2, C8.-, C9.-, C11.2, C12.-, D2.A, IC2.15 (GND), IC3.4 (GND), JP1.1, JP1.7, JP1.8, JP1.9, JP1.10, JP2.1, OK1.5 (GND), R1.E, R3.1, R7.2, R11.2, R18.1, R25.1, X3.1, X4.4
unnamed: IC1.4 (PD2(INT0)), R6.1
unnamed: C1.2, IC1.9 (PB6(XTAL1/TOSC1)), Q1.2
unnamed: C2.2 (A), IC1.10 (PB7(XTAL2/TOSC2)), Q1.1
unnamed: IC1.23 (PC0(ADC0)), JP1.13
unnamed: IC1.24 (PC1(ADC1)), JP1.12
unnamed: IC1.25 (PC2(ADC2)), JP1.11
unnamed: IC1.26 (PC3(ADC3)), JP1.6
unnamed: IC1.27 (PC4(ADC4/SDA)), JP1.5
unnamed: IC1.28 (PC5(ADC5/SCL)), JP1.4
unnamed: IC1.16 (PB2(SS/OC1B)), JP1.14
unnamed: IC2.13 (R1IN), JP2.2
unnamed: JP1.3, R1.S
unnamed: IC1.3 (PD1(TXD)), IC2.11 (T1IN)
unnamed: IC1.2 (PD0(RXD)), IC2.12 (R1OUT)
unnamed: C6.1, IC2.6 (V-)
unnamed: C5.1, IC2.2 (V+)
unnamed: C3.2, IC2.3 (C1-)
unnamed: C3.1, IC2.1 (C1+)
unnamed: C4.1, IC2.4 (C2+)
unnamed: C4.2, IC2.5 (C2-)
unnamed: IC2.14 (T1OUT), JP2.3
unnamed: IC1.13 (PD7(AIN1)), R14.2, R21.2
unnamed: IC1.5 (PD3(INT1)), R5.1
unnamed: D3.C, D4.C, R12.2, R13.2, R26.1, T3.3 (E), T4.3 (E)
unnamed: IC1.11 (PD5(T1)), PAD3.1
unnamed: D1.A (ANODE), F1.1, R10.1
unnamed: OK1.3 (C), X4.2
unnamed: C9.+, D1.C (CATHODE), IC3.6 (VCC), R16.1, R26.2
unnamed: F1.2, X3.2
unnamed: OK1.2 (A), R2.1
unnamed: IC1.22 (GND), R3.2
unnamed: R2.2, X4.1
unnamed: C12.+, R5.2, R10.2, R11.1
unnamed: OK1.8 (VCC), R6.2
unnamed: C1.1, C2.1 (E), IC1.8 (GND), R7.1
unnamed: IC2.16 (VCC), R4.2, X4.3
unnamed: IC3.5 (COMP), R17.2, R18.2
unnamed: C11.1, IC3.3 (TC)
unnamed: D2.C, IC3.2 (SWE), L2.1
unnamed: IC3.1 (SWC), IC3.7 (IPK), IC3.8 (DRC), R16.2
unnamed: C10.-, D5.A, D6.A, R8.1, R9.1, R22.1, R24.1, R25.2, T1.3 (E), T2.3 (E), T5.E, T6.E
unnamed: R21.1, R22.2, T5.B
unnamed: R9.2, R29.1, T1.1 (B)
unnamed: IC1.12 (PD6(AIN0)), R15.2, R23.2
unnamed: R23.1, R24.2, T6.B
unnamed: R8.2, R15.1, T2.1 (B)
unnamed: D4.A, D5.C, D7.A, T1.2 (C), T4.2 (C), X1.1
unnamed: D3.A, R27.2, T3.2 (C)
unnamed: R13.1, R20.2, T4.1 (B)
unnamed: R12.1, R19.2, T3.1 (B)
unnamed: R30.1, T5.C
unnamed: D6.C, D7.C, R27.1, T2.2 (C), X1.2
unnamed: R14.1, R29.2
unnamed: R20.1, T6.C
unnamed: R19.1, R30.2
VCC: C7.1, C8.+, C10.+, IC1.7 (VCC), IC1.20 (AVCC), JP1.2, L2.2, R1.A, R4.1, R17.1

Notes on the sheet:
Induktivität 150mH
Schaltregler 5V
HD44780 LCD Display
24V +
24V -
Anschluß DCF77 Modul
GND
Data +
Data -
Uhr
Spannungsausfallerkennung

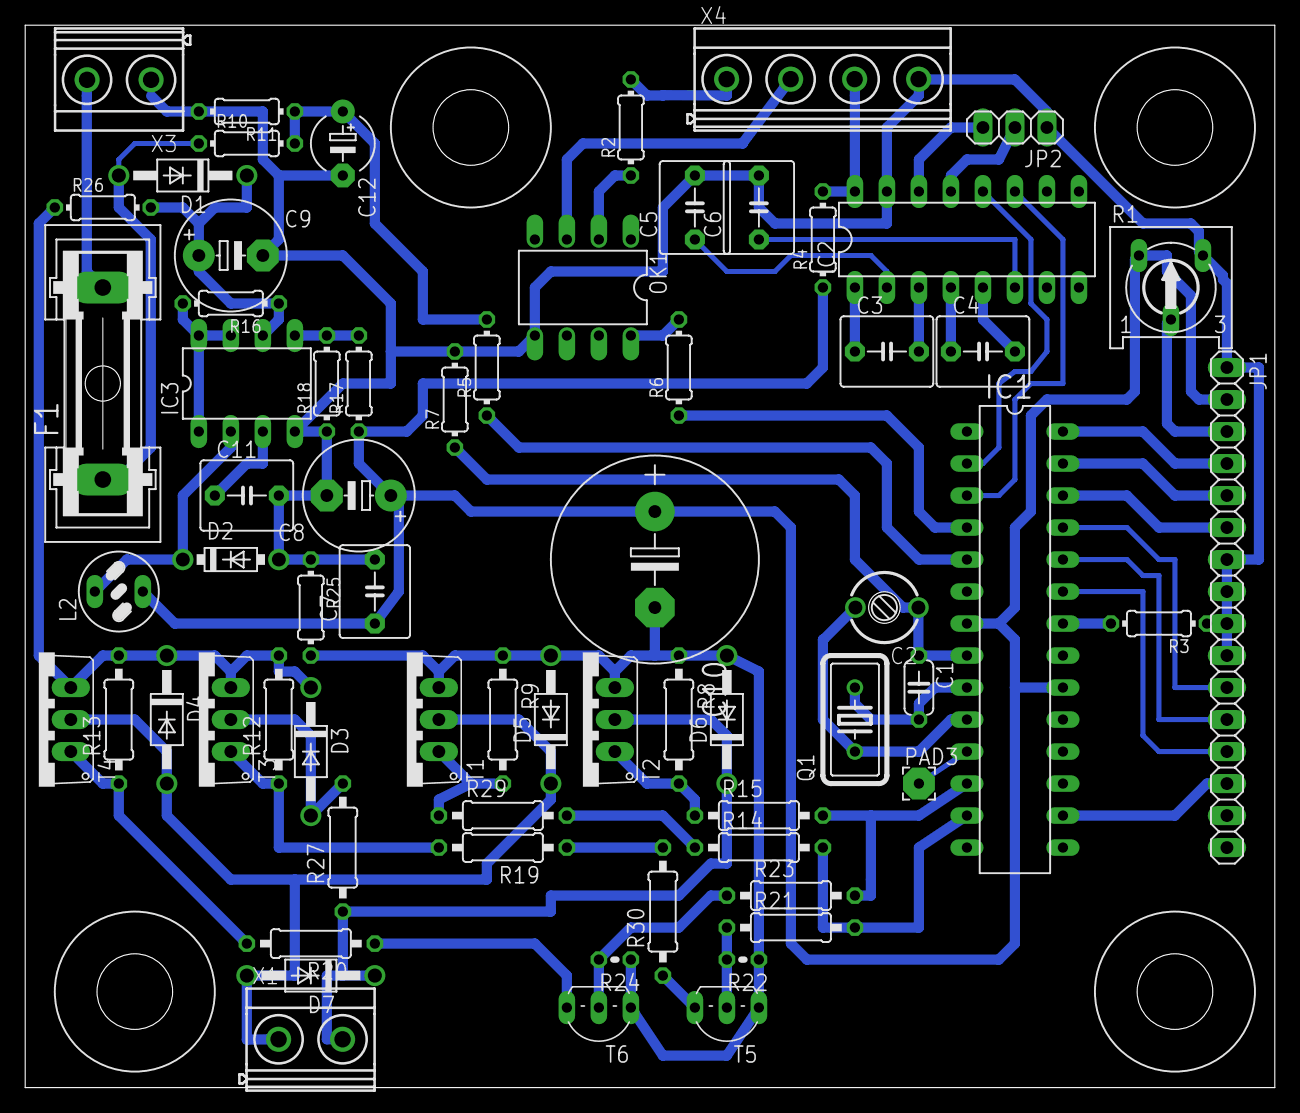
[picture p29: board Hardware/Mutteruhr V1.0/mutteruhr-Haus.brd from above]

Board: 1 copper layer, 99.2 x 84.3 mm, 71 parts (0 on the bottom side), 57 nets.

Other parts of the board:
U$1, U$2, U$3, U$4: DRIL-6
