Race666/masterclock/Hardware/Mutteruhr V2.1 External USB-B - H-Brigde L298 - USB UART LM2576-5/RS232-Board.brd

## EAGLE design Hardware/Mutteruhr V2.1 External USB-B - H-Brigde L298 - USB UART LM2576-5/RS232-Board.brd (2016-11-09)

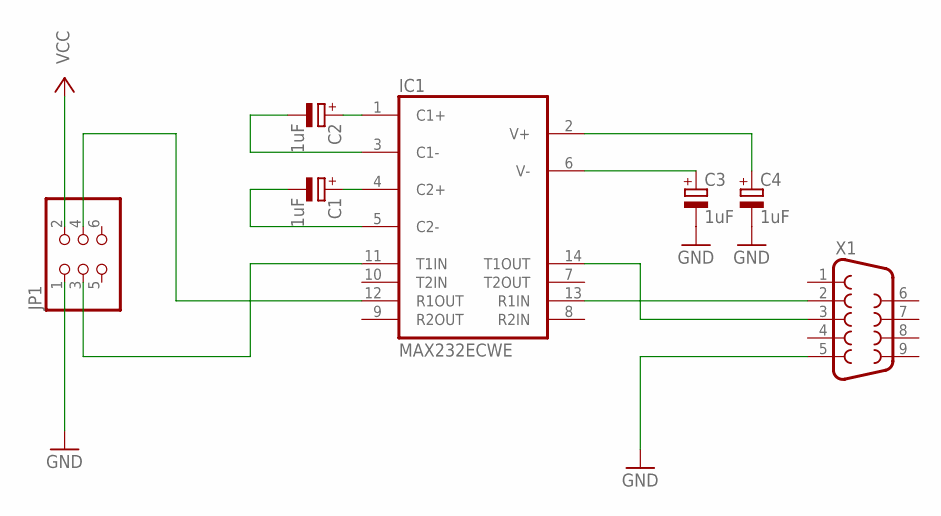
[picture p30: schematic RS232-Board.sch]

Parts:
C1, C2, C3, C4: 1uF; E2,5-6E
IC1: MAX232ECWE; SO16L
JP1: PINHD-2X3; 2X03
X1: F09H

Connections:
GND: C3.-, C4.-, IC1.15 (GND), JP1.1, X1.5
unnamed: C1.+, IC1.4 (C2+)
unnamed: C1.-, IC1.5 (C2-)
unnamed: IC1.13 (R1IN), X1.2
unnamed: C2.-, IC1.3 (C1-)
unnamed: C2.+, IC1.1 (C1+)
unnamed: C3.+, IC1.6 (V-)
unnamed: C4.+, IC1.2 (V+)
unnamed: IC1.14 (T1OUT), X1.3
unnamed: IC1.12 (R1OUT), JP1.4
unnamed: IC1.11 (T1IN), JP1.3
VCC: IC1.16 (VCC), JP1.2

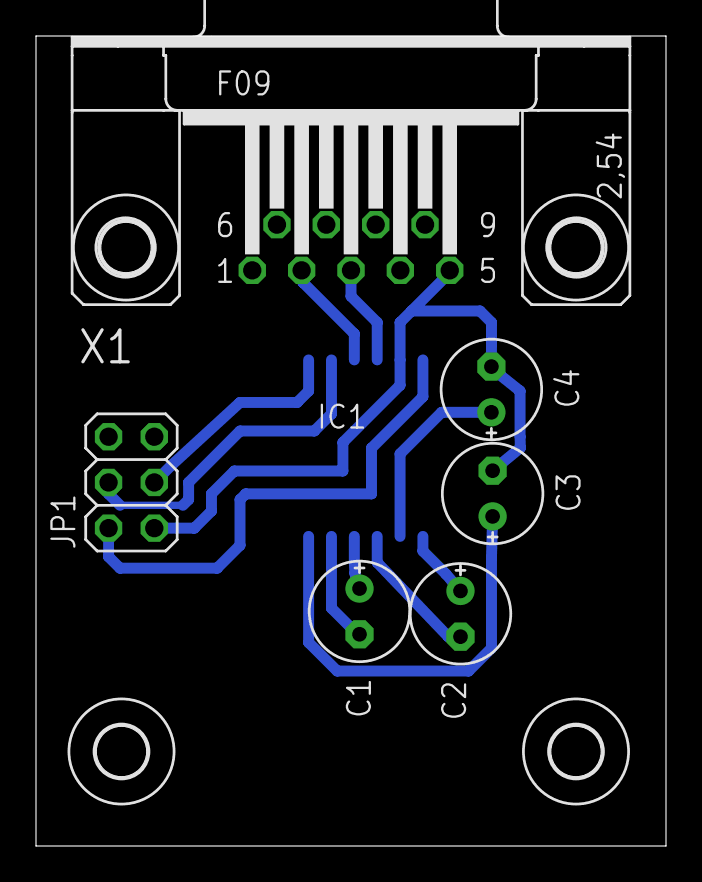
[picture p31: board RS232-Board.brd from above]

Board: 2 copper layers, 35.0 x 45.0 mm, 11 parts (1 on the bottom side), 12 nets.

Other parts of the board:
U$1, U$2, U$3, U$4: 2,8
