Race666/masterclock/(commit log)

2016-11-09 Hardware V1.0, V2.0, V2.1 hinzugefuegt
    [RS232-Board.brd, RS232-Board.sch, USB-Board.brd, USB-Board.sch, dcf77kompZDiff.brd, dcf77kompZDiff.sch, mutteruhr-Haus.brd, mutteruhr-Haus.sch]
2020-07-01 Fehler an USB MCP2200 VDD gefixt. Verbindung Pin 1 - 17 getrennt
    [USB-Board.brd, USB-Board.sch, mutteruhr-Haus.brd, mutteruhr-Haus.sch]
2023-12-17 Hardware Revision V3
    [DCF77 Receiver-B_Cu.gbr, DCF77 Receiver-B_Mask.gbr, DCF77 Receiver-B_Paste.gbr, DCF77 Receiver-B_SilkS.gbr, DCF77 Receiver-Edge_Cuts.gbr, DCF77 Receiver-F_Cu.gbr, DCF77 Receiver-F_Mask.gbr, DCF77 Receiver-F_Paste.gbr]
